Daoud1190/Reception_moteur_main/README.md

## Reception main robotisé
   

> © INRACI

https://github.com/Daoud1190/Reception_moteur_main/assets/146357859/5e3157b3-9342-42ab-822f-edbbf6c9f63c



## Table des matières
- [Source du projet](#source-du-projet)
- [Introduction](#introduction)
- [Les caractéristiques](#les-caractéristiques)
  - [Général](#général)
  - [Electronique](#electronique)
  - [Mécanique](#mécanique)
- [Liste des composants](#liste-des-composants)
  - [Electronique](#electronique-1)
  - [Mécanique](#mécanique-1)
- [Schéma bloc](#schéma-bloc)
  - [Gant](#gant)
  - [Main](#main)
- [Schéma de principe sans connecteur](#schéma-de-principe-sans-connecteur)
- [Fichier sources easyEDA](#pcb)

## Source du projet
[Gotronic Blog](https://www.gotronic.fr/blog/articles/controle-dune-main-robotique/)



## Introduction
A l'occasion de mon TFE de fin de 6ème année secondaire, j’ai décidé de mener un projet qui va me permettre d’appliquer mes connaissances acquises grâce à mon apprentissage à l’INRACI. 
Le but de mon projet est de créer une main que l’on pourra contrôler grâce à un gant à distance. 
Mes motivations pour ce projet viennent de ma passion pour la domotique et le contrôle à distance. 
Depuis tout petit, je suis fasciné par les entités contrôlées à distance et ce projet est l’occasion de rallier ce que j’aime et l’électronique. 
Rapide explication :
Les servos moteurs qui seront reliés aux doigts de la main robotique vont être branchés à une première carte ESP32 qui communiquera avec une deuxième carte ESP32. Cette dernière sera branchée aux 5 capteurs de flexion qui seront collés aux gants. Les deux cartes pourront communiquer grâce à leurs options BT intégrées.  

## Les caractéristiques
### Général
| | Main | Gants |
|---|---|---|
| 2 boutons poussoir | Sur la carte ESP32 | Sur la carte ESP32 |
| 1 LED | LED sur la carte ESP32 | LED sur la carte ESP32 |
| Main robotique avec 5 servos moteurs| Servo moteur SG90 | X |
| Gants avec 5 capteurs de flexion (x résolutions)| X | A déterminer |

### Electronique
| | Main | Gants |
|---|---|---|
| BT 2,4 GHz | Sur la carte ESP32 | Sur la carte ESP32 |
| Consommation | 170 et 250 mA pour les 5 servos moteurs | ESP32 (80-180 mA) |
| Batteries 5 volt | A déterminer | A déterminer |

### Mécanique
| | Main | Gants |
|---|---|---|
| Poids | 289g | 5g |
| Matière | Acrylique noir 5.0 | Tissu |

## Liste des composants
### Electronique
- [2X Adafruit Carte Feather HUZZAH32 ESP32](https://www.adafruit.com/product/3405)
- [5x Capteur de Force, ZD10-100 500g](https://www.gotronic.fr/art-capteur-de-force-flexiforce-100-lb-31526.htm)
- 1X Batterie
- [1X M5PAPER](https://shop.m5stack.com/products/m5paper-esp32-development-kit)
- 5X résistances smd
- 1X interrupteur
- 5X fusibles réarmable PTC

### Mécanique
- 1X Bras mécanique
- [5X servo moteur (SG90)](https://www.towerpro.com.tw/product/sg90-7/)
- 1X Gants en tissus

## Schéma bloc
### Gant


### Main


##  Schéma de principe sans connecteur


## PCB
(https://oshwlab.com/daoud01/pcb-moteur)

> [!NOTE]
> Appuyer sur l'image pour acceder au projet sur Easyeda
