Daoud1190/Reception_moteur_main/Oulad_El_Fadel_Main_Robotisée.pdf

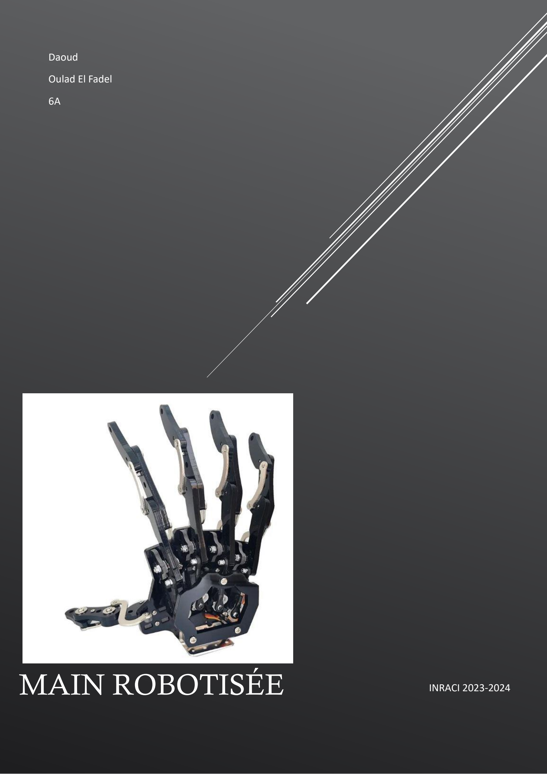
[picture p1: page 1]

Daoud

Oulad El Fadel

6A

MAIN ROBOTISÉE | INRACI 2023-2024

« Si vous voulez trouver les secrets de l'univers, pensez en termes d'énergie, de fréquence, d'information et de vibration. »

— Nikola Tesla

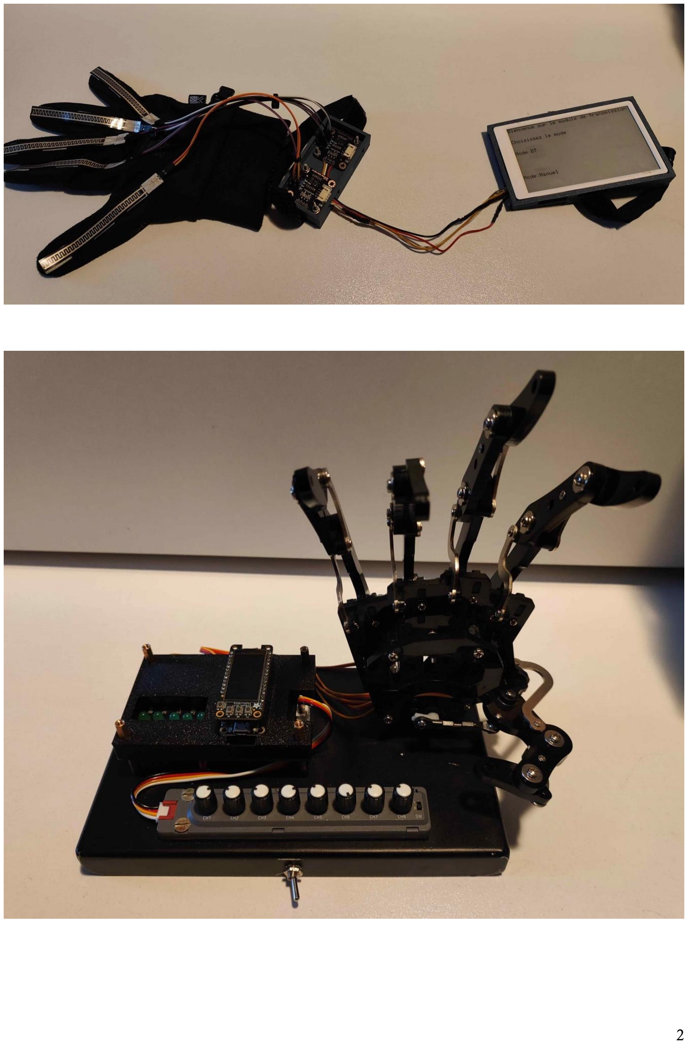
[picture p2: page 3]

Mes remerciements les plus sincères à mon promoteur monsieur Kapita pour sa formation et la mise à disposition de son temp et de son matériel pour mener à bien mon projet. Une personne inspirante qui a mon plus grand respect.

Mes remerciements à Thomas Giarrizzo qui a été un camarade exceptionnel et d’une grande aide. Je voudrais aussi remercier mes parents et Nathan et mes autres camarades pour le soutient qu’ils m’ont apporté.

Table des matières

## 1. L’introduction

À l’occasion de mon TFE de fin de 6-ème année secondaire. J’ai décidé de mener un projet qui va me permettre d’appliquer mes connaissances acquises grâce à mon apprentissage à l’INRACI.

Le but de mon projet est de crée une main que l’on pourra contrôle grâce à un gant à distance.

Mes motivations pour ce projet viennent de ma passion pour la domotique et le contrôle à distance.

Depuis tout petit je suis fascinée par les entités contrôler à distance et se projet est l’occasion de rallier ce que j’aime et l’électronique.

Rapide explication

Les servos moteurs qui seront reliés aux doigts de la main robotique vont être branchés à une première carte ESP32 qui communiquera avec la même carte. La deuxième carte sera elle branchée aux 5 capteurs de flexion qui seront collés aux gants. Les 2 cartes pourront communiquer grâce à leurs options BT intégrées.

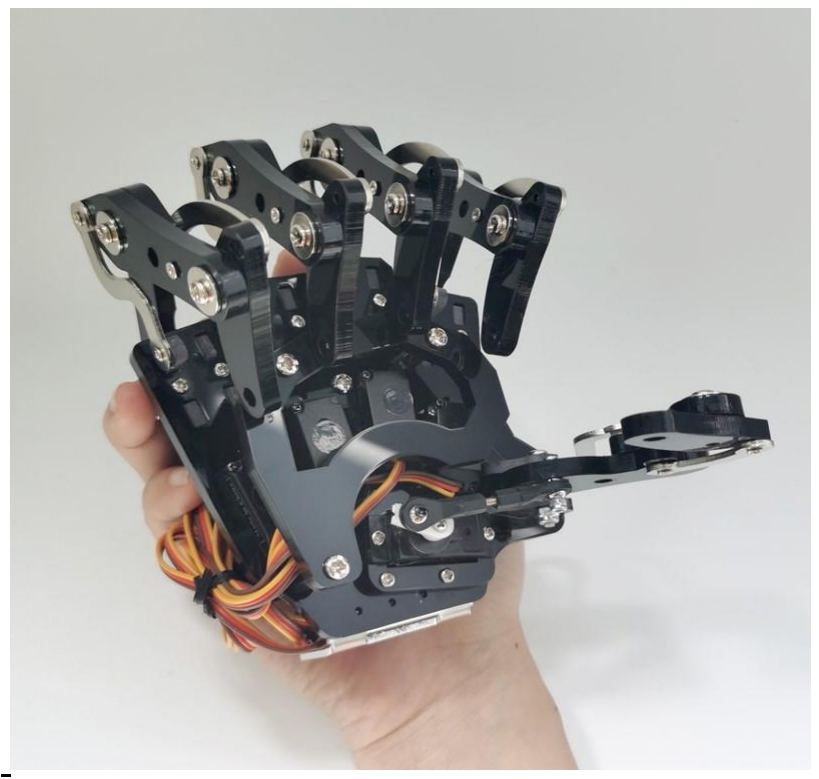
[picture p3: figure]
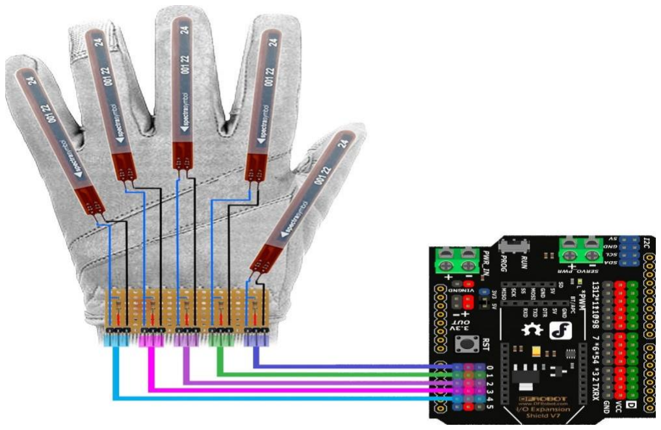
[picture p4: figure]

## 2. Les caractéristiques

Caractéristiques :

Général : | Main | Gants
-2 boutons-poussoirs | Sur la carte ESP32 | Sur la carte ESP32
-1 Led | LED sur l’Esp32 | LED sur l’Esp32
-Main robotique avec 5 servomoteurs | Servomoteur SG90 | X
-Gants avec 5 capteurs de flexions (x résolutions) | X | Capteur de flexion ZD10-100
Électronique : | Main | Gants
-BT 2,4 GHz | Sur la carte ESP32 | Sur la carte ESP32
-Consommation | 170 et 250 mA pour les 5 servomoteurs | ESP32 (80-180 mA)
-Batteries 5 volts | X | Inclus (dans la m5 Paper)
Mécanique : | Main | Gants
Poids | 289g | 5g
Matière | Acrylique noir 5.0 | Tissu

Liste des composants :

Électronique

-2X Adafruit Carte Feather HUZZAH32 ESP32

- 5x Capteur de Force, ZD10-100 500g

-2X Batteries (a determiner)

-1X M5PAPER

Mécanique

-1X Bras mécanique

-5X servomoteurs (SG90)

-1X Gants en tissus

## 3. Les principes mis en jeu

Démodulation

Description détaillée

Notre projet comporte 2 parties (le gant avec une M5 Paper et la main robotique avec une ESP32) qui vont se transmettre des informations via une connexion Bluetooth. Nos 2 dispositifs de communication sont dotés de ce type de transmission. Cette technologie de transmission de données nous permet d’échanger des données entre la M5 Paper et l’ESP32. Elle nous permet aussi d’avoir une communication sécurisée grâce au chiffrement de données et d’avoir un temps de connexion rapide.

Caractéristiques détaillées

1 Portée de communication

La portée de communication est de 10 mètres entre nos 2 systèmes.

2 Fréquence de communication

La fréquence utilisée est de 2,4 GHz.

3 Maitre multiple

Il peut avoir plusieurs esclaves contrôlés par 1 seul maitre.

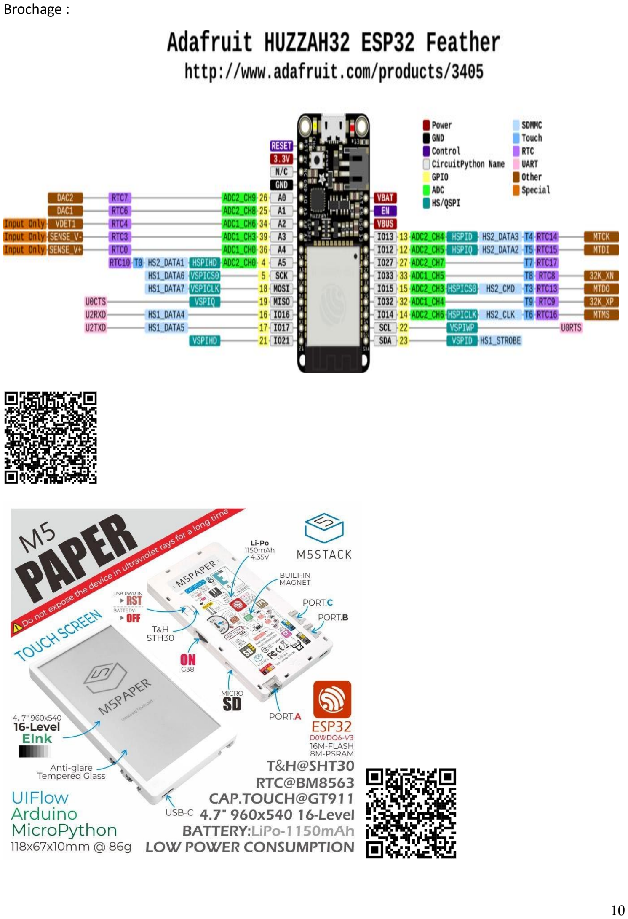
[picture p5: page 11]

Brochage :

Étude théorique du principe physique de la réception (démodulation) Bluetooth.

Le principe de modulation utilisé est le GFSK qui est une technique de variation de fréquences qui est utilisée pour transmettre des données.

L’émetteur (M5 Paper) va envoyer les données moduler en GFSK via une radiofréquence vers l’esp32.

L’ESP32 grâce à une antenne va capter l’onde et acheminer le signal vers le circuit de réception.

Avant d’arriver à l’étape de démodulation le signal va être filtré, le bruit capté va être éliminé et le signal utile va être renforcé.

Le circuit de réception va démoduler le signal reçu en traduisant les variations de fréquence pour récupère les données originales.

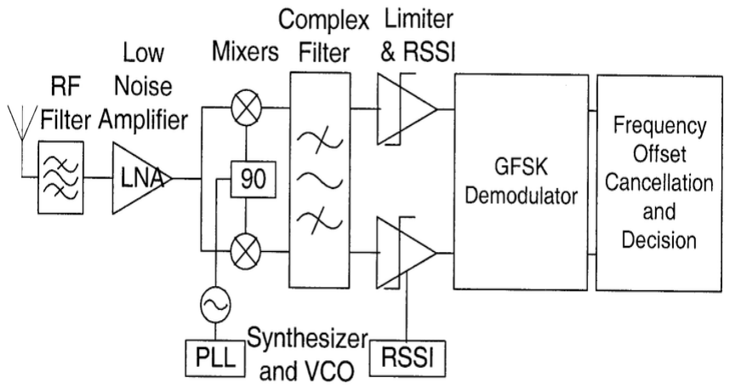
[picture p6: figure]

Programmes de test

char receiveData[7] //Tableau pour stocker les données reçues

// Initialisation de la communication série Bluetooth SerialBT.begin(device_name);
// Définition du code PIN pour le couplage Bluetooth SerialBT.setPin(pin);
Serial.println("Using PIN");

if (SerialBT.available()) {
SerialBT.write(Serial.read());
DATA = SerialBT.read(); // Lire le caractère envoyé via Bluetooth }

// Affiche les données reçues Serial.println(receiveData[0]); Serial.printf("a:%d\n", receiveData[1]); Serial.printf("b:%d\n", receiveData[2]); Serial.printf("c:%d\n", receiveData[3]); Serial.printf("d:%d\n", receiveData[4]); Serial.printf("e:%d\n", receiveData[5]); Serial.printf("f:%d\n", receiveData[6]);

Librairie utiliser

"BluetoothSerial.h" version 1.0.1.

Auteur : Henri Abrahamsen (https://www.arduinolibraries.info/authors/hen1227)

Site consulté le 31/01/2024 à 21 :43

"ESP32Servo.h" version 1.1.2
Auteur: Kevin Harrington, John K. Bennett Site consulté le 14/02/2024 à 21 :26

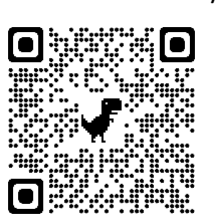
[picture p7: figure]

Voici le lien pour en savoir plus sur le code (https://github.com/Daoud1190/Reception_moteur_main)

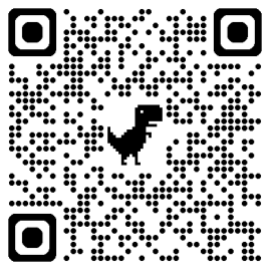
[picture p8: figure]

Encodeur

Introduction

L’un des sous-ensembles de notre projet est le 8-encoder Unit qui nous permet de contrôler les moteurs qui contrôlent les doigts de la main. Les encodeurs utilisés pour notre projet sont les EC11 qui sont des encodeurs incrémentaux. La position des encodeurs est communiquée grâce à microcontrôleur en I2C vers notre ESP32.

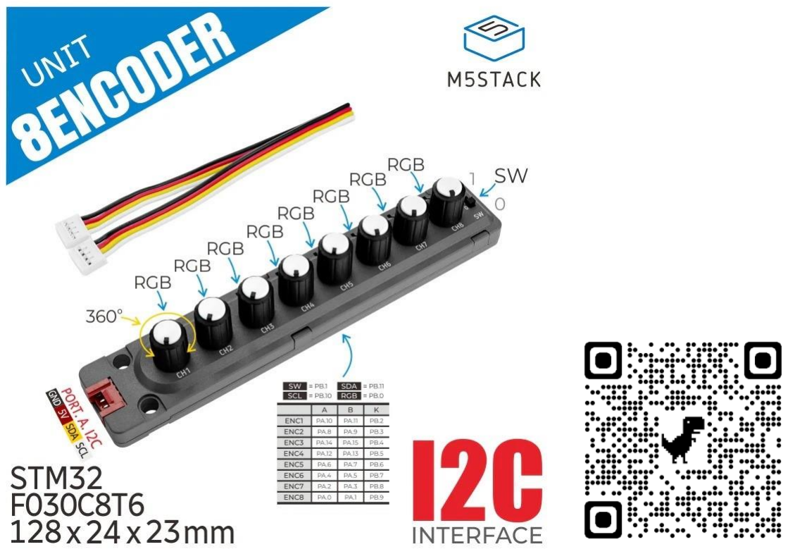
[picture p9: figure]

Fonctionnement d’un encodeur incrémental

Définition :

Un encodeur incrémental est un capteur qui suit le mouvement d’un objet en incrémentant ou décrémentant sa position par rapport à une position de référence.

L’encodeur incrémental est constitué de 2 parties : le stator et le rotor.

Le rotor est la partie tournante qui est relié l’entité dont on souhaite mesurer la position, la distance ou la vitesse.

Le stator est la partie fixe sur laquelle se trouve le capteur qui va nous permettre de mesurer les données que l’on veut (vitesse, position, etc.).

Fonctionnement :

Pin « DT » : Son rôle est de fournir un signal de données qui changent selon la position des contacts.

Pin « CLK » : Son rôle est de fournir un signal d’horloge qui change selon la position des contacts.

Pin « commune » : Elle est branchée au GND.

L’encodeur est composé d’un disque qui comporte des zones blanches conductrices et des zones noires non conductrices. Lorsque l’on va tourner le disque, l’un des 2 groupes de pin va passer sur une zone conductrice ce qui va créer un court-circuit.

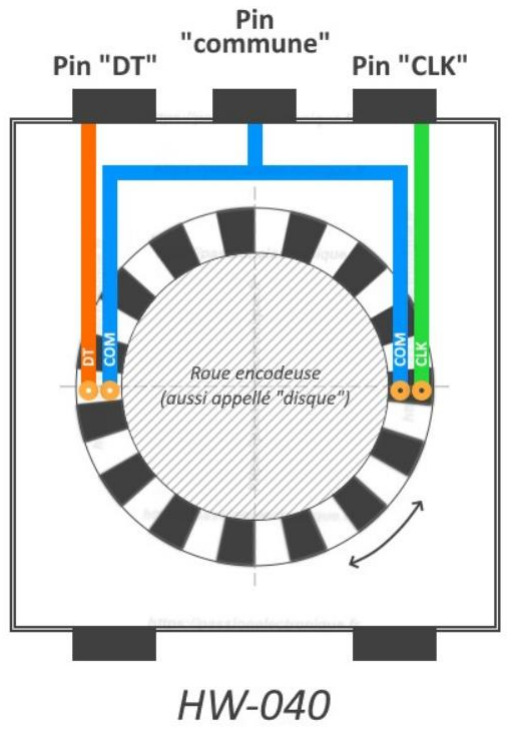
[picture p10: figure]

Traitements des impulsions électriques

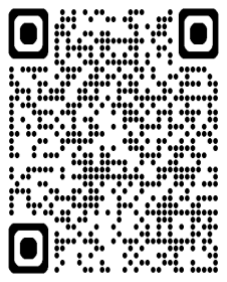
[picture p11: figure]

Pour obtenir l’information souhaitée, il faut traiter les impulsions électriques générées par le capteur. Le système chargé d’effectuer le traitement des impulsions est un compteur qui va compter les impulsions et incrémenter ou décrémenter selon le déplacement de l’objet.

Le codeur va délivre 2 signaux carrés (A et B) grâce à des contacts mécanique qui vont alterner entre l’état ON ou OFF ce qui va créer un déphasage qui va nous permettre de déterminer la position de l’objet et le sens de rotation. Chaque configuration des interrupteurs correspond à une position.

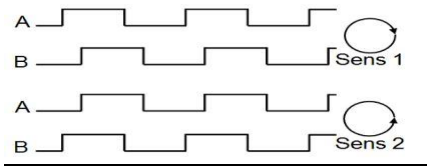
[picture p12: figure]

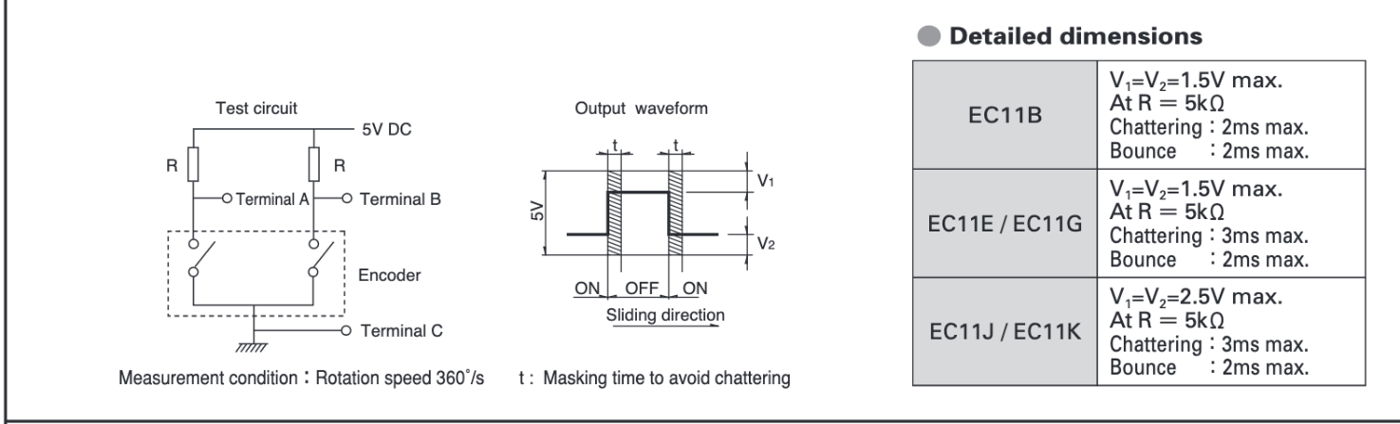
[picture p13: figure]

Les signaux A et B se comporte comme des interrupteur ouvert (ON) ou fermer (OFF) ce qui crée 2 choses :

Chattering : Variation indésirable dans les signaux.

Bounce : Rebondissement des « interrupteurs » mécanique après une ouverture ou une fermeture ce qui cause des variations indésirables dans le signal.

C’est 2 phénomènes nous montre qu’il y a une fréquence limite à ne pas dépasser pour avoir un signal lisible.

Programme de test :

void index() {
encoderValue1 = MM.getAbsCounter(1); // Lecture de la position de l’encodeur mappedValue1 = map(encoderValue1, 0, 100, 50, 100);

// Vérification des limites de l’encodeur
if (encoderValue1 <= 0) {
encoderValue1 = 0;
MM.setAbsCounter(1, 0); // Réinitialisez l’encodeur à 0

} else if (encoderValue1 >= 220) {
encoderValue1 = 220; // Forcer encoderValue à 350 si c’est le cas MM.setAbsCounter(1, 220); // Réinitialisez l’encodeur à 0
}
}
LIBRAIRIE : M5ROTATE8 (https://github.com/RobTillaart/M5ROTATE8)
Version : 0.3.0

Voici le lien pour en savoir plus sur le code (https://github.com/Daoud1190/Reception_moteur_main)

## 4.Le schéma bloc

Gant

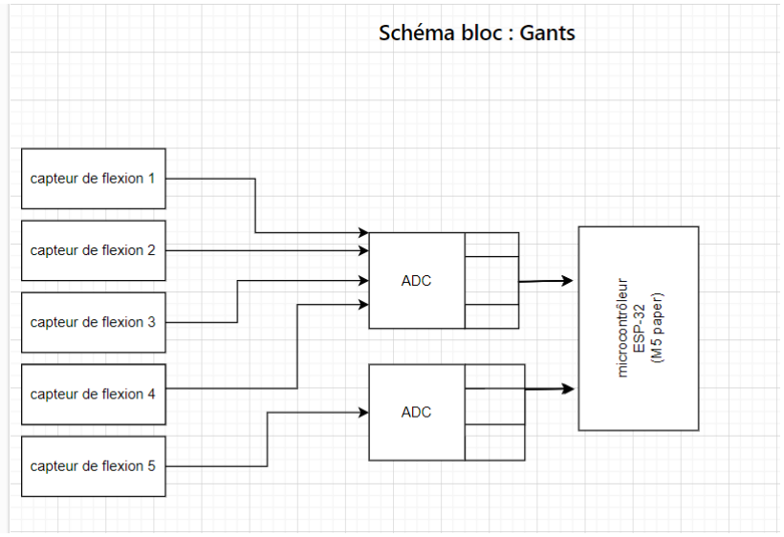
[picture p14: figure]

Gants :

Capteur de flexion et module ADC :

Les capteurs de flexion vont transmettre le mouvement à la ESP32 (M5 Paper) grâce à deux modules I2c. 2 capteurs de flexion dans l’un des modules et 3 dans l’autre. Les modules vont permettre de relier les capteurs de flexions au microprocesseur en réduisant le nombre de connexions.

M5 Paper :

L’ESP32(M5 Paper) va envoyer les instructions à l’ESP32 de la main robotisée grâce au module BT intégré. L’écran tactile intègre va afficher la position des doigts et le menu pour pouvoir choisir les différents modes de fonctionnement.

Main

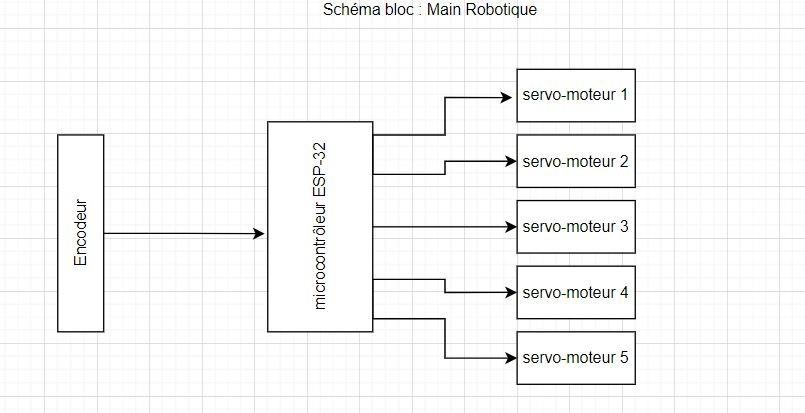
[picture p15: figure]

Main robotisée :

ESP32 et servomoteur :

Le microprocesseur de la main robotique va recevoir les instructions grâce au module BT intégré qui va ensuite les appliquer sur les ou le servomoteur concerner. L’ESP-32 va renvoyer la postions des doigts vers la M5 Paper a fin de l’afficher.

Encodeur :

Il est composé de 8 encodeurs mécaniques qui vont nous permettre de faire bouger “manuellement” nos doigts. L’encodeur est branché à l’ESP-32 qui va contrôler les moteurs selon la position des encodeurs attitrés à chaque doigt.

## 5.L’étude détaillée et les mesures

Analyse de l’écran (M5 PAPER)

Introduction
Notre projet se constitue de la M5 Paper qui va nous permettre de communiquer la position des capteurs à notre main robotique. La M5 Paper est aussi composer d’un écran le EPD_ED047TC1 qui va nous permettre d’afficher les diffèrent modes (contrôle avec le gant, mouvement avec l’écran et le mode musique) et de les sélectionner grâce au tactile de l’écran. Il va aussi nous permettre de contrôler la main robotique en appuyant directement sur le choix de la position des doigts.

Comment marche l’affichage ?
L’écran utilise la technologie E-Ink qui permet un affichage à très faible consommation et n’a pas besoin d’énergie pour laisser une image afficher, car il ne consomme que lorsque l’image est modifiée. L’écran est composé de pixels dans lesquelles il y a de l’encre composée de billes de pigments chargé positivement pour créer un pigment blanc et négativement pour créer un pigment noir qui baignent dans un fluide transparent. Lorsque l’on va vouloir afficher la couleur noire, nous allons envoyer une tension électrique négative pour attirer les billes de pigments blancs et repousser de l’autre cotée du fluide, une tension positive pour attirer les billes de pigments noirs et repousser les charges négatives de l’autre cotée du fluide. Sans présence de tension, les pigments restent à leur place.

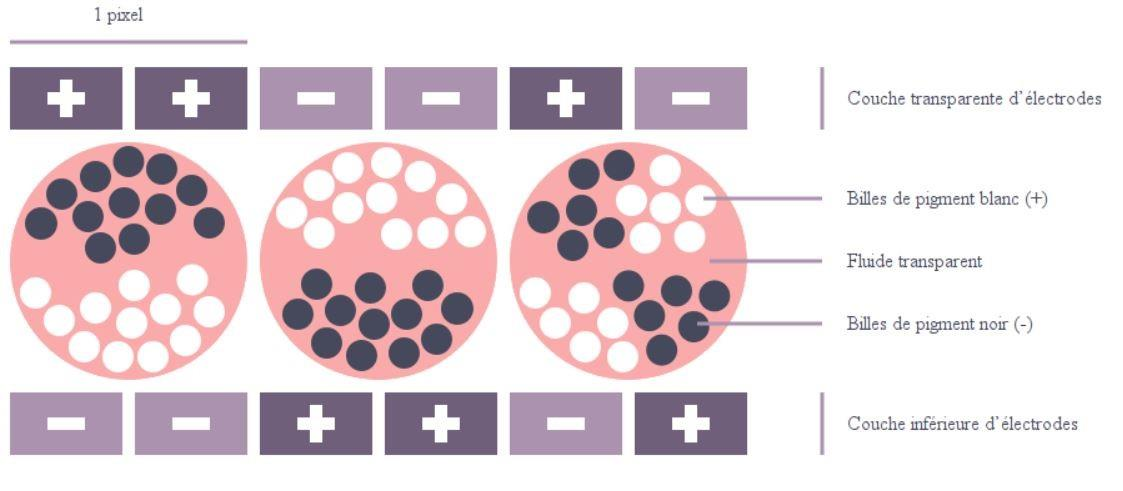
[picture p16: figure]

Comment fonctionne le tactile ?
L’écran va être traversé par un champ électrique faible qui quadrille l’écran. Le doigt est un conducteur électrique et lorsque l’on va appuyer sur une partie de l’écran le champ électrique va être perturbé et le processeur va pouvoir sur quelle partie du quadrillage le champ a été perturber.

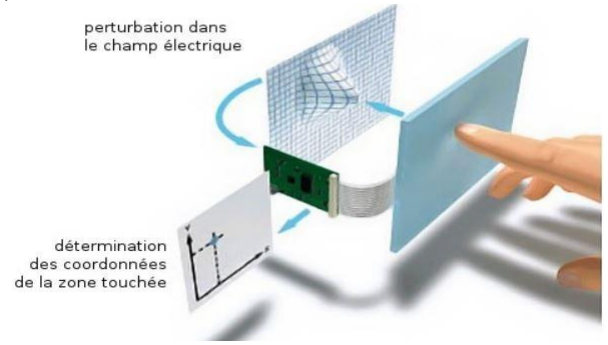
[picture p17: figure]

Code de “teste”:

if (M5.TP.available()) {
if (!M5.TP.isFingerUp()) { M5.TP.update();
canvas.fillCanvas(0);
bool is_update = false;
for (int i = 0; i < 2; i++) {
tp_finger_t FingerItem = M5.TP.readFinger(i); if ((point[i][0] != FingerItem.x) || (point[i][1] != FingerItem.y)) { is_update = true;
point[i][0] = FingerItem.x;
point[i][1] = FingerItem.y;
canvas.fillRect(FingerItem.x - 50,FingerItem.y - 50,00,100,15);
Serial.printf("Finger ID:%d-->X: %d*C | Y: %d | Size: %d\r\n",
FingerItem.id, FingerItem.x, FingerItem.y, FingerItem.size);
}
}
if (is_update) {
canvas.pushCanvas(0, 0, UPDATE_MODE_DU4); }
}
}
}

Voici le lien pour en savoir plus sur le code (https://github.com/Thomas2809/transmission)

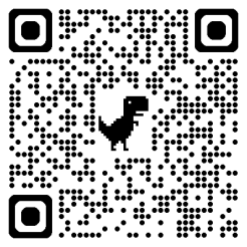
[picture p18: figure]

Caractéristiques de l’écran :
Taille diagonale : 4,7" (https://www.panelook.com/sizmodlist.php?sizes%5b%5d=470)
Zone active : 58,32 (L) × 103,68 (H) mm
Type d’interface : Données parallèles (1 canal, 8 bits), connecteur 44 broches Résolution : 540 × 960, qHD 235 PPI
Fréquence : 85Hz
Tension d’entrée : 3,3 V (typique)
Environnement : Température de fonctionnement : 0 ~ 50 °C ; Température de stockage. : -25 ~ 70 °C
Niveau de gris : 16

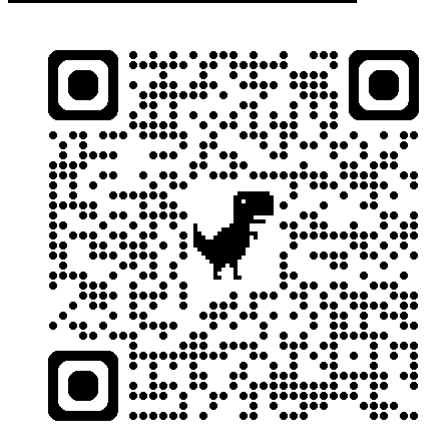
[picture p19: figure]

Datasheet de l’écran

Module ADS1115

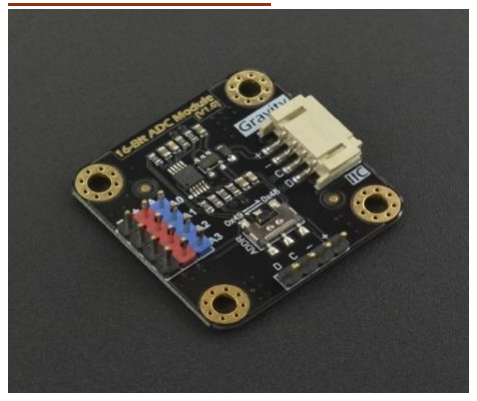
[picture p20: figure]

Introduction

Pour transmettre à notre MCU le signal analogique qui correspond à la position du doigt acquise grâce à nos capteurs de flexion nous avons besoin de d’abord convertir le signal analogique en signal numérique. Ce rôle sera rempli grâce à nos 2 modules ADC.

Qu’est-ce qu’un ADC

C’est un périphérique qui convertit un signal analogique en signal numérique.

Schéma interne du module ADS1115

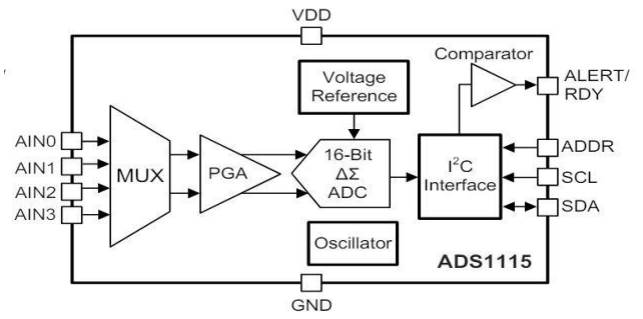
[picture p21: figure]

AIN correspond à l’entrée analogique de notre convertisseur.

Le MUX corresponds à un multiplexeur qui va sectionner l’entrée que nous voulons lire.

Le signal va ensuite passer par le PGA (Programmable Gain Amplifier) qui va amplifier le signal avec un Gain que l’on peut programmer.

Ensuite le signal est traité par le convertisseur delta-sigma de 16-bits pour récupérer un mot binaire. 16 bits représentent les différentes tensions disponibles (65536).

L’interface I²c permet de communiquer nos valeurs numériques au microcontrôleur qui les traiter.

Le comparateur va comparer la tension d’entrer du bloc interface I²c a une tension de référence et va créer une alerte quand la tension de référence est dépassée.

L’oscillateur permet de synchroniser les différents blocs entre eux grâce un signal d’horloge.

Capteur de flexion

Introduction

Pour notre projet nous avons besoin de connaitre la position des doigts de l’utilisateur et pour cela nous allons utiliser des capteurs de flexions.

Qu’est-ce qu’un capteur de flexion

Le capteur de flexion est une bande dont la résistance va varier selon la flexion que l’on exercer avec.

Le capteur est constitué d’encre polymère composée de particules conductrices qui vont s’écarter lorsque l’on plie le capteur ce qui va augmenter la résistance. Selon le degré de flexion, la résistance va varier.

Le capteur doit être utilisé avec une résistance (8k2Ω dans notre cas) pour créer un pont diviseur de tension qui va lui permettre d’être lu par un convertisseur analogique /numérique.

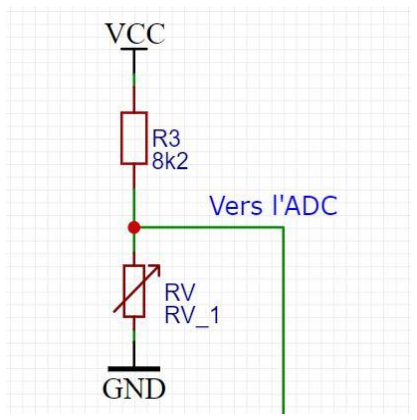
[picture p22: figure]
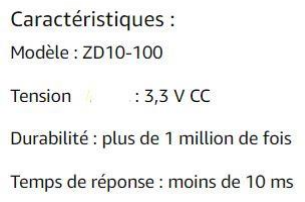
[picture p23: figure]

Le capteur de flexion a besoin d’un pont diviseur de tension pour pouvoir être lu par l’ADC.

Formule :

Rv
Rv+R3

. VCC = U adc

I²C

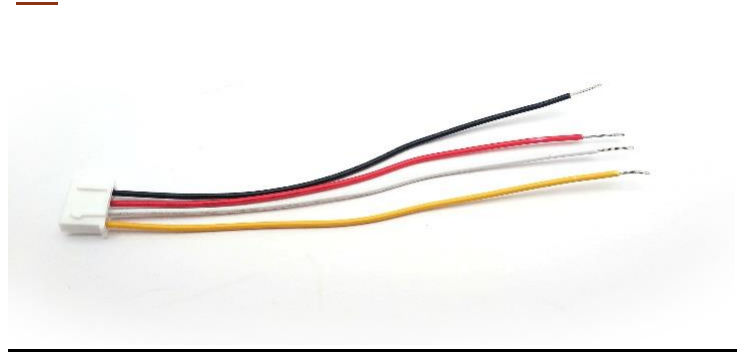
[picture p24: figure]

Introduction

Dans notre projet nous avons besoin de faire communiquer nos modules entre eux et pour cela nous avons besoin d’un bus de communication qui dans notre cas est le bus I²C.

qu’est-ce qu’un bus I²C

L’I²C est un bus de communication développé par PHILIPS dans les années 80 et qui avait pour but de relier plusieurs périphériques à un seul microprocesseur.

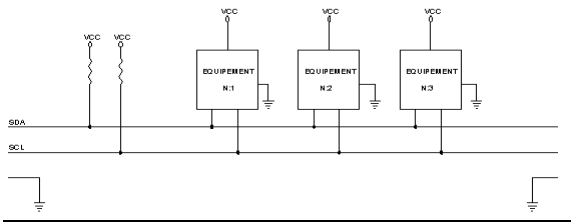
[picture p25: figure]

L’I2C est composée de 3 fils : SDA, SCL, Masse.

Il est half duplex donc on peut lire et écrire, mais pas en même temps.

Le SDA représente le signal de la data qui correspond à nos données.

Le SCL représente le signal d’horloge qui synchronise les appareils entre eux.

Pour communiquer, les périphériques doivent avoir une adresse. Dans ce cas nous avons la transmission d’une adresse.

Les bits d’A6 à A0 contiennent l’adresse. L’adresse est unique pour chaque appareil.

Le bit R / W indique si le maitre s’apprête à lire ou écrire.

Un bit ACK (Acknowledge) doit être envoyé par le périphérique qui a reçu l’adresse pour confirmer au maitre qu’il l’a bien reçu.

Écriture

SCL correspond au signal d’horloge.

SDAM correspond au signal envoyer par le maitre.

SDAE correspond au signal envoyer par l’esclave.

SDAR correspond aux 2 signaux.

Ici nous pouvons voir l’adresse de A6 à A0 avec le R/W et ACK ensuite nous avons les donner de D7 à D0 et un ACK à la fin que l’esclave doit envoyer pour confirmer la réception.

Lecture d’une donnée par le maitre

Après avoir lu la donnée, le maitre va mettre ACK à 0 si il veut lire les autres données.

Mesures sur les servomoteurs

| T (ms) | F (Hz) | Ton (ms) | Rapport cyclique r ((Ton /T). 100) )
0° | 20ms | 50Hz | 528us | 2,64
90° | 20ms | 50Hz | 1,46ms | 7,3
180° | 20ms | 50Hz | 2,36ms | 11,8

On peut remarquer que plus l’angle est grand plus le rapport cyclique augmente.

Moteur à 0°

Période

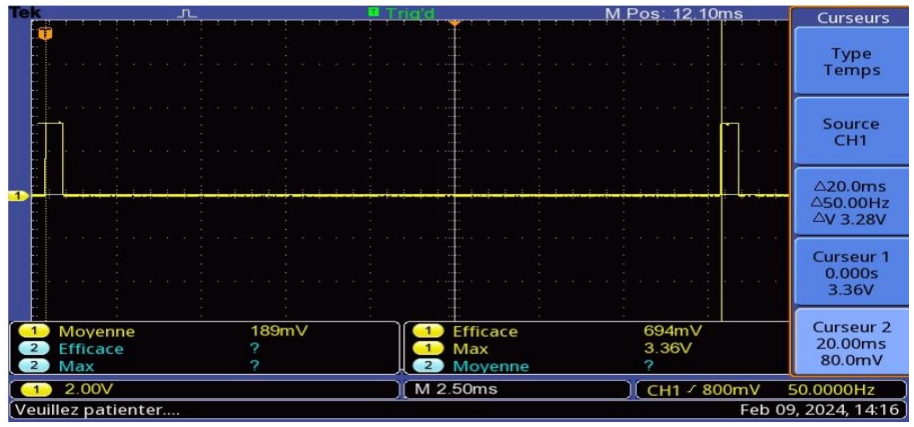
[picture p26: figure]
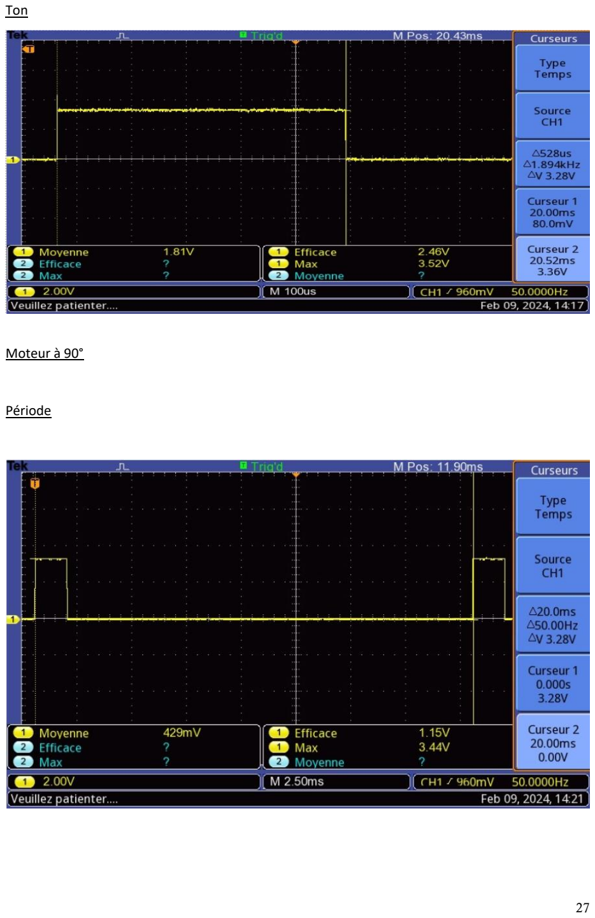
[picture p27: page 28]

Ton

Moteur à 90°

Période

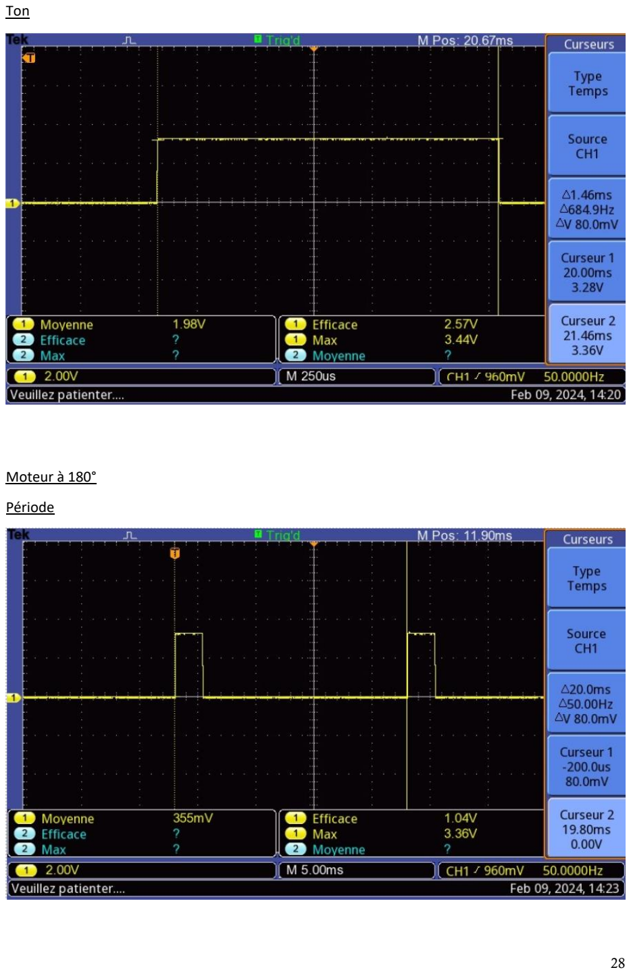
[picture p28: page 29]

Ton

Moteur à 180°

Période

Ton

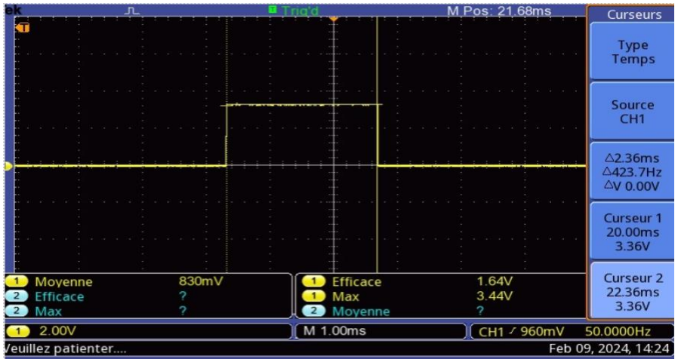
[picture p29: figure]

Mesure sur les capteurs de flexion
| Mesure (volt mètre) | Mesure (Ohm mètre) | Calcul du programme (ADC25ADC25) | Valeur en binaire
Sans flexion | 2,267V | 18k Ω | 245 | 6143 0b 0001 0111 1111 1111
Flexion a 90° | 2, 3V | 7k3Ω | 131 | 4262 0b 0001 0000 1010 0110
Flexion totale | 722mV | 2k3Ω | 83 | 489 0b 0001 1110 1001

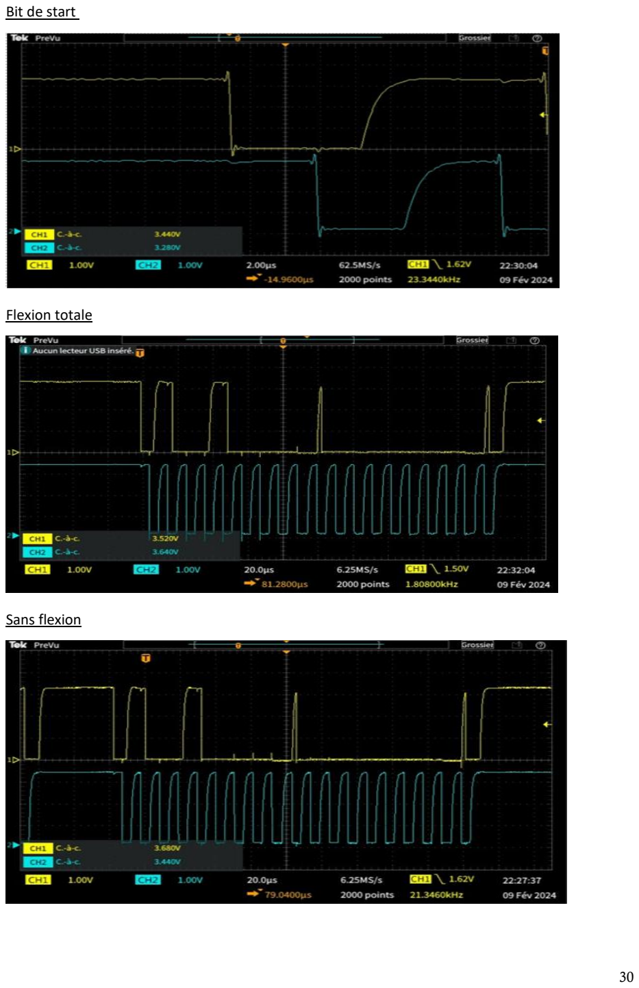
[picture p30: page 31]

Bit de start

Flexion totale

Sans flexion

Mesure de l’interruption

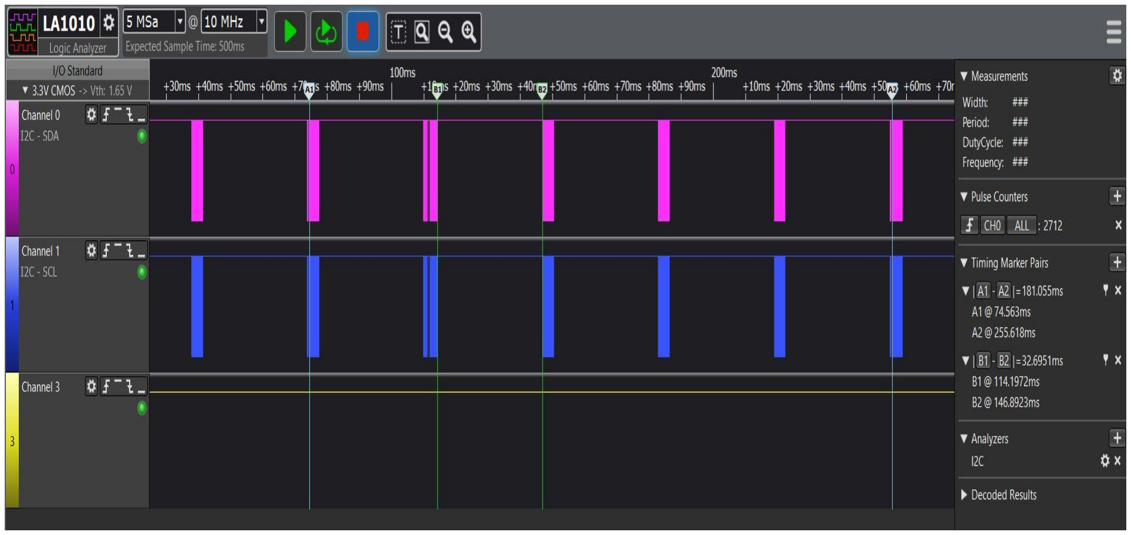
[picture p31: figure]

L’espace entre les curseurs A1 et A2 représentent la durée d’une interruption (180ms)

L’espace entre les curseurs B1 et B2 représentent la durée entre le traitement de chaque doigt (on peut voir les traitements qui correspondent à chaque doigt)

## 6.La programmation

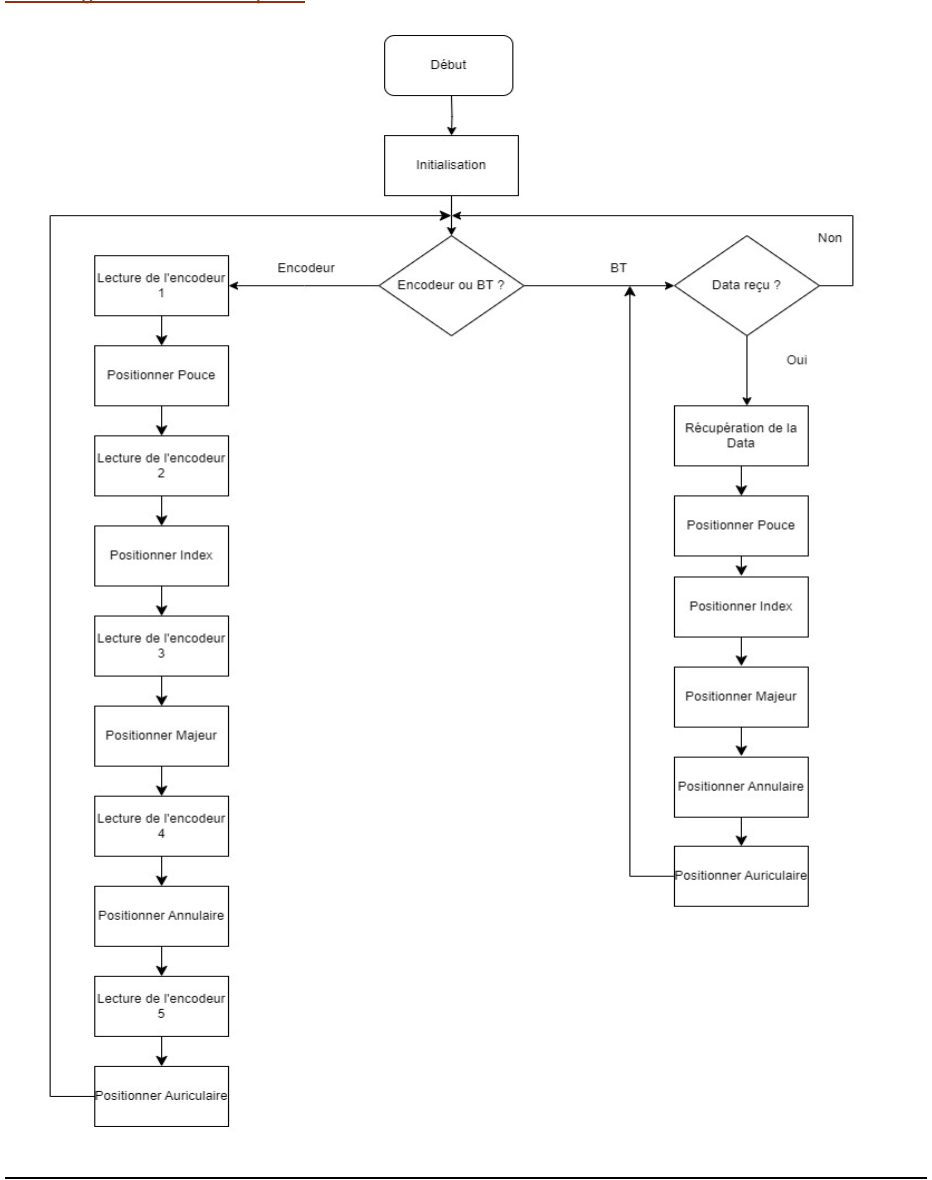
[picture p32: figure]

L’ordinogramme de la réception

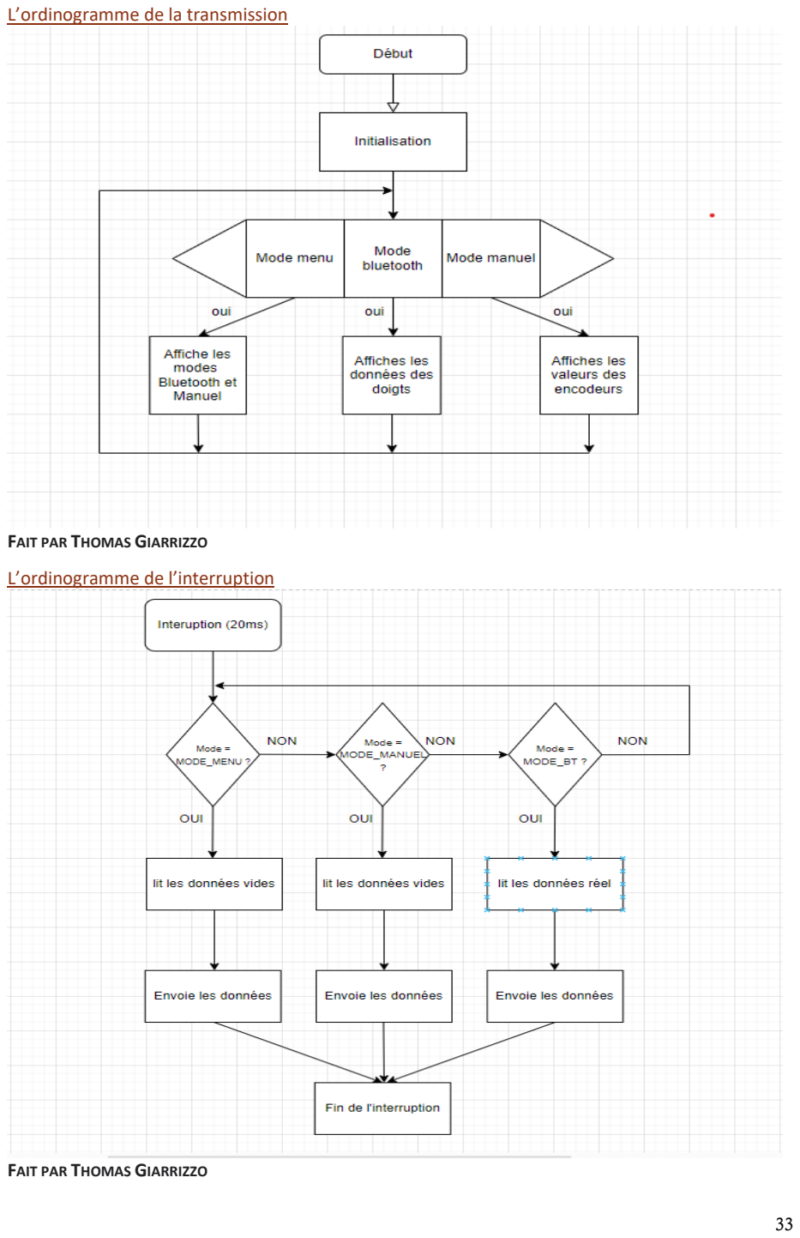
[picture p33: page 34]

L’ordinogramme de la transmission

FAIT PAR THOMAS GIARRIZZO

L’ordinogramme de l’interruption

FAIT PAR THOMAS GIARRIZZO

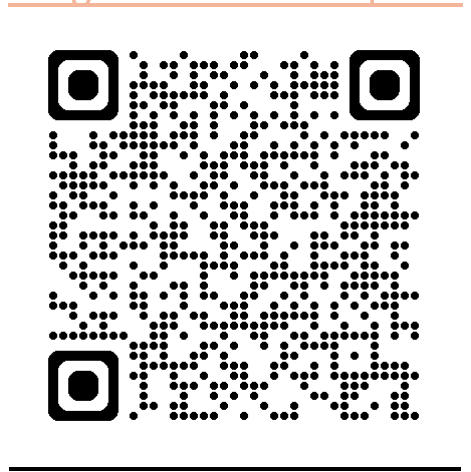
[picture p34: figure]

Programme de réception (https://github.com/Daoud1190/Reception_moteur_main)

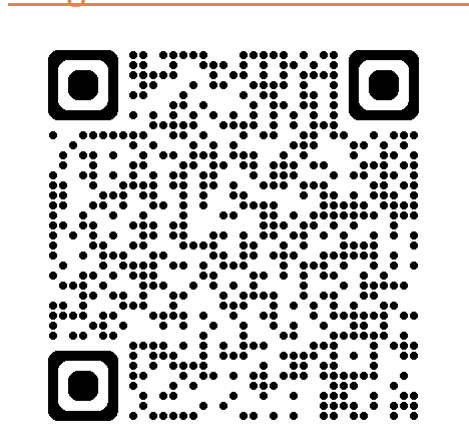
[picture p35: figure]

Programme de transmission (https://github.com/Thomas2809/transmission)

## 7. La fabrication

- Premièrement, j’ai commandé ma main et conçu mon PCB en attendant de recevoir la main.
- Après avoir tout reçu, j’ai conçu le plan du support, plier, découper et fais des trous sur de la taule. Ensuite mon père a soudé les coins.
- Pour la partie du gant, j’ai d’abord soudé les ADC pour faire les tests et les mesures et ensuite créer les plans des supports pour la M5, des modules et le capot de mon PCB. Après avoir effectué mes mesures sur les ADC j’ai branché tous mes capteurs de flexion et les ai collés avec du scotch double face aux gants.
- Enfin j’ai mis des entretoises pour fixer le PCB et placer l’interrupteur.
- Pendant tout le procédé de la conception mécanique, je codais en même temps le programme de réception.

## 8. La mise au point

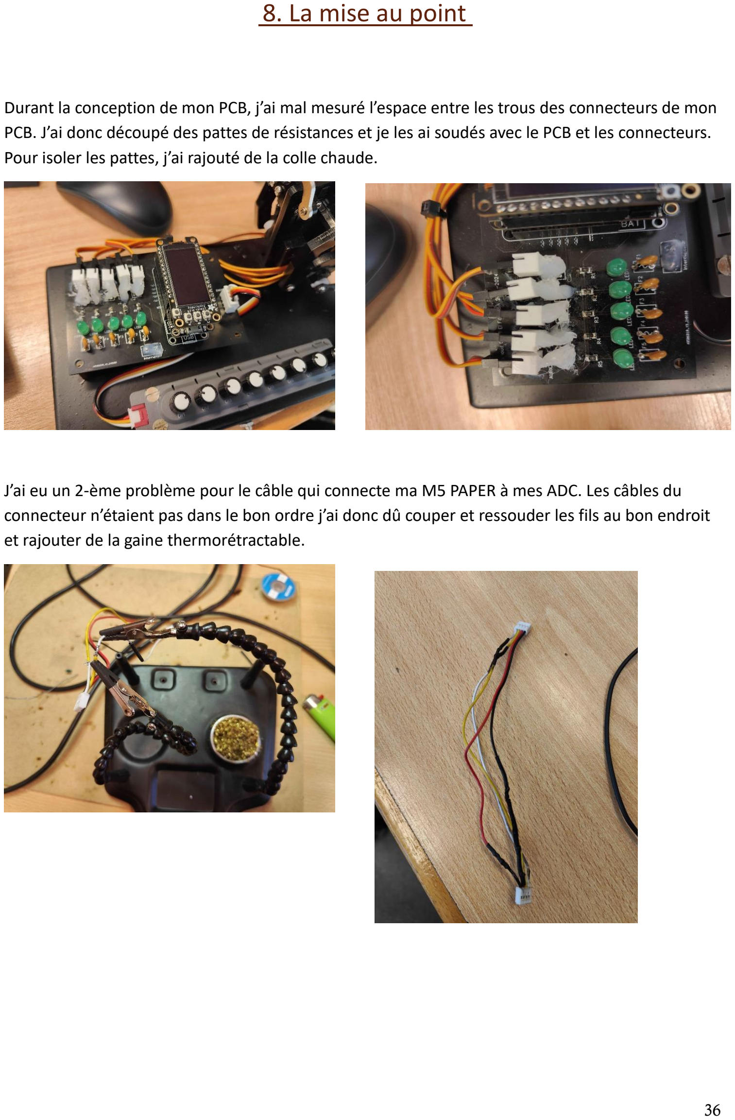
[picture p36: page 37]

Durant la conception de mon PCB, j’ai mal mesuré l’espace entre les trous des connecteurs de mon PCB. J’ai donc découpé des pattes de résistances et je les ai soudés avec le PCB et les connecteurs. Pour isoler les pattes, j’ai rajouté de la colle chaude.

J’ai eu un 2-ème problème pour le câble qui connecte ma M5 PAPER à mes ADC. Les câbles du connecteur n’étaient pas dans le bon ordre j’ai donc dû couper et ressouder les fils au bon endroit et rajouter de la gaine thermorétractable.

## 9. La conclusion

En conclusion, je suis content du résultat de mon projet même si j’aurais aimé rajouter quelque fonctionnalité en plus (ajouter une caméra qui détecte la position des doigts, contrôler les doigts grâce au tactile).

J’ai aimé faire ce projet et le partager avec les gens de mon entourage.

Cette expérience a été enrichissante pour moi, j’ai beaucoup appris et j’ai aimé partager mes travaux et aider les autres.

De plus, le fait de travailler en équipe pour mon projet m’a beaucoup aidé. J’ai pu appliquer mes compétences en électronique et les étendre pendant la conception de mon projet.

## 10. Les annexes

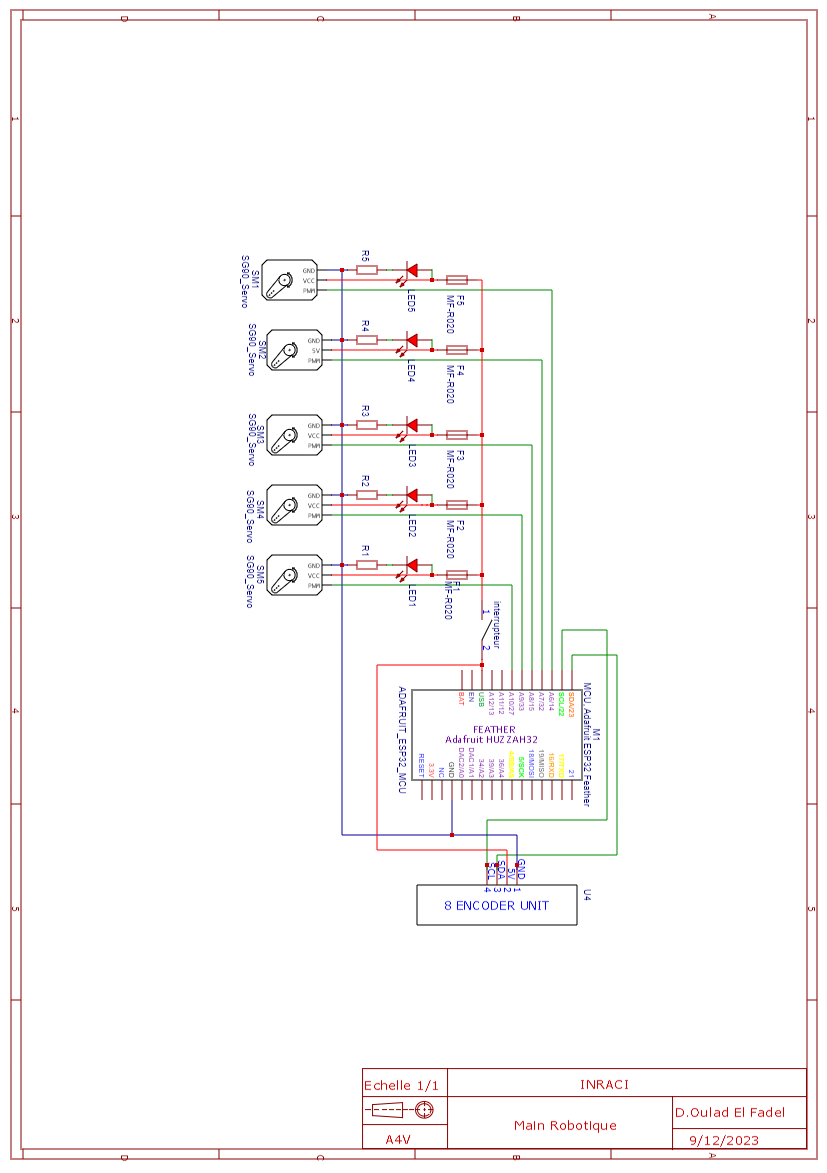
[picture p37: figure]

Schéma de principe sans connecteur

Dessin de PCB avec les pistes

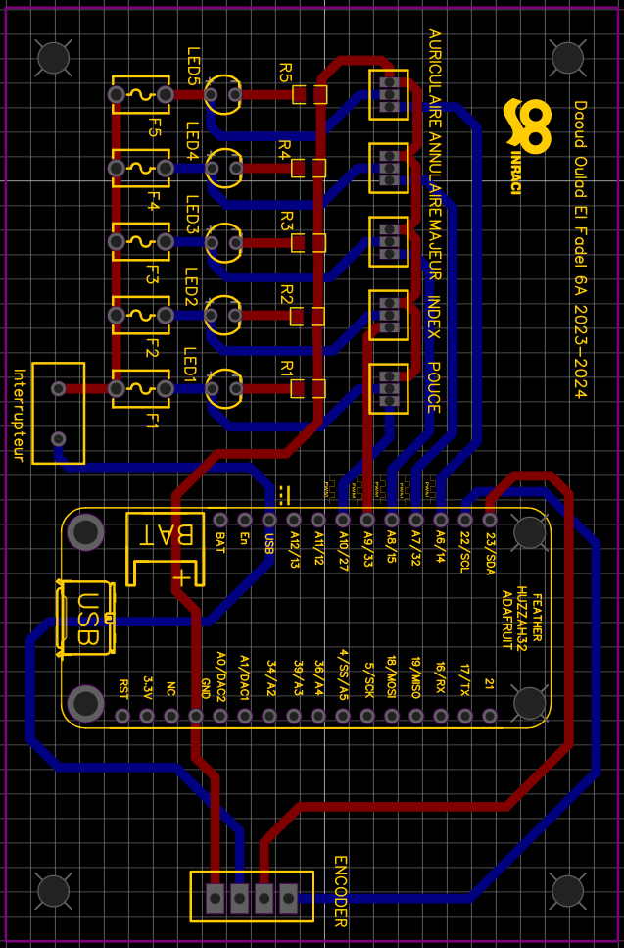
[picture p38: figure]

Dessin de PCB sans les pistes

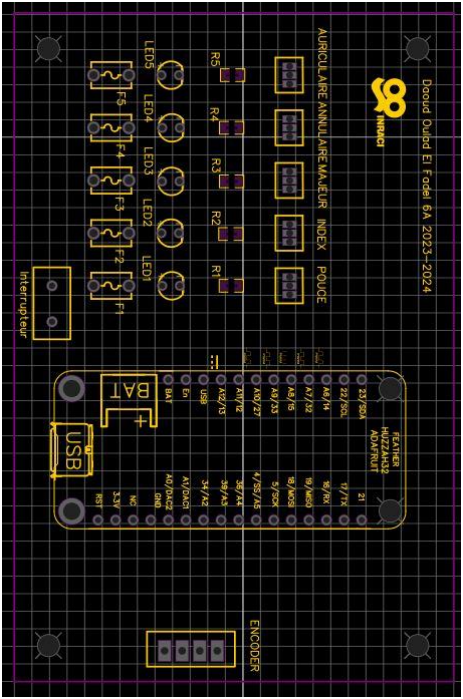
[picture p39: figure]

## 11. Vue 3D

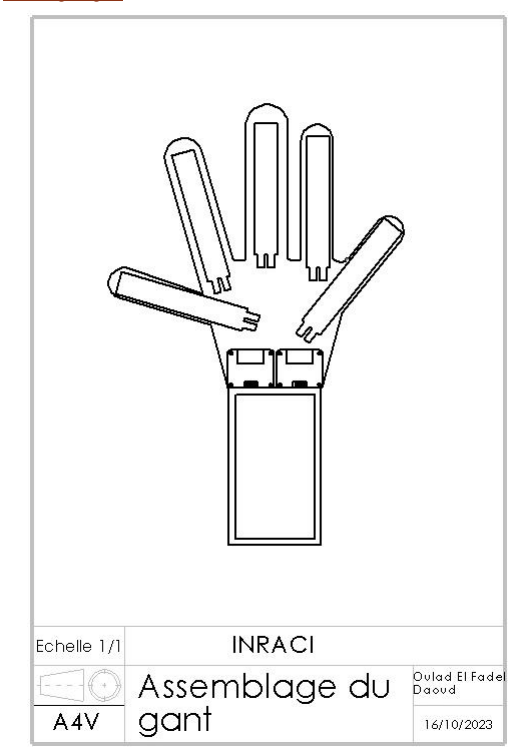
[picture p40: figure]

Assemblage du gant

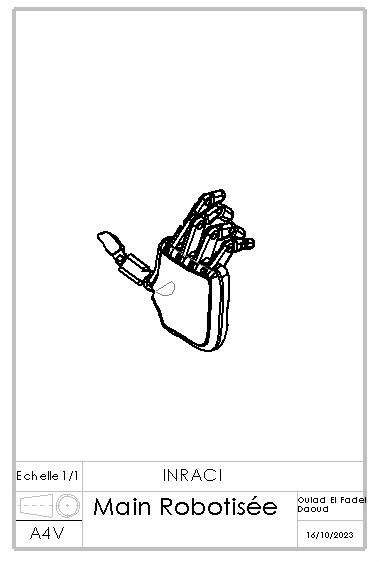
[picture p41: figure]

Main robotisée

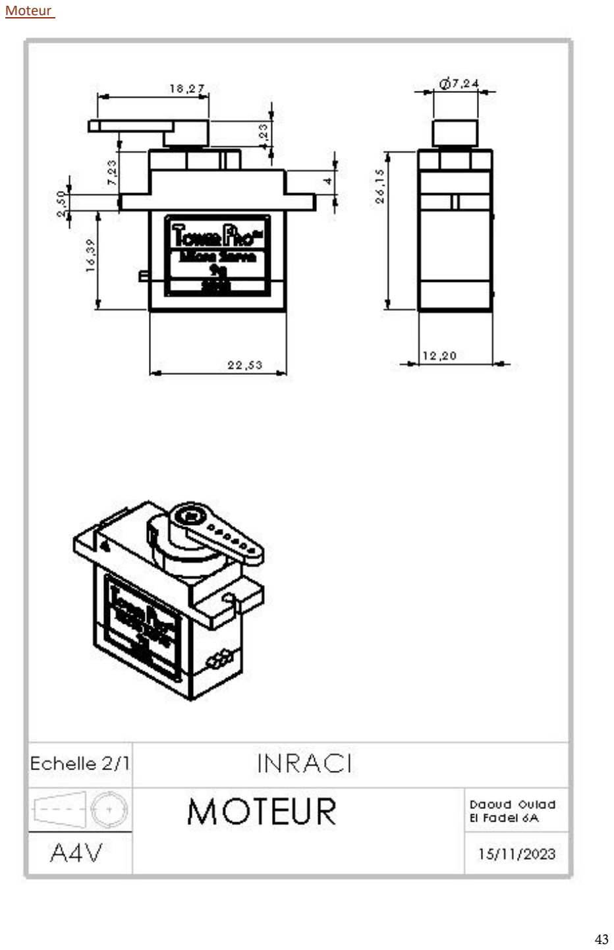
[picture p42: page 44]

Moteur

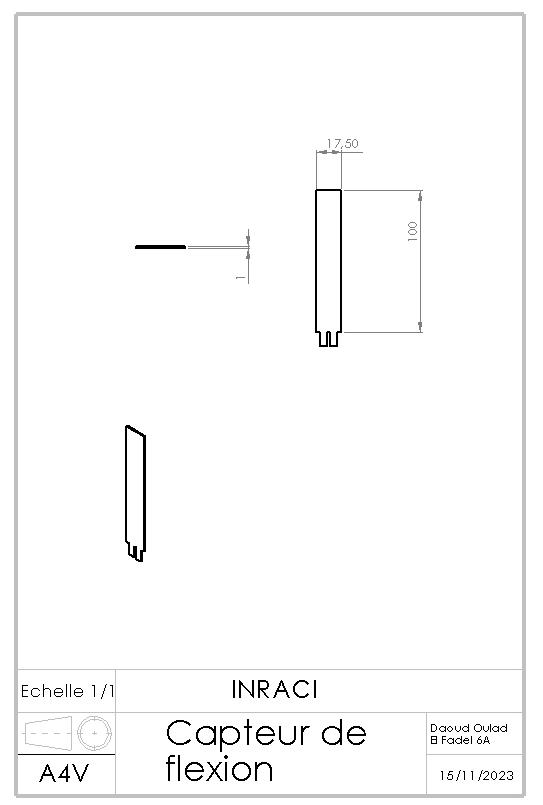
[picture p43: page 45]

Capteur de flexion

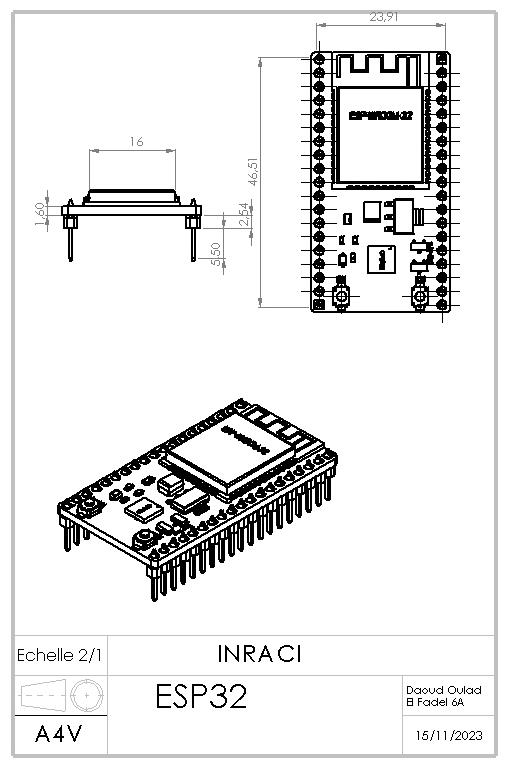
[picture p44: page 46]

ESP32

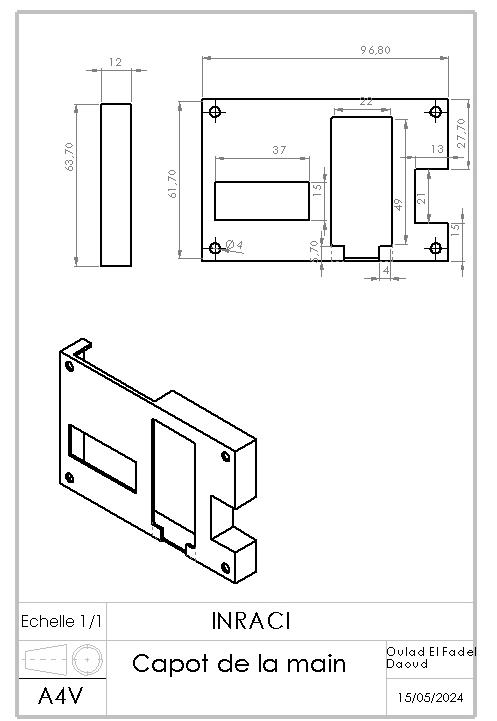
[picture p45: page 47]

Capot de la main

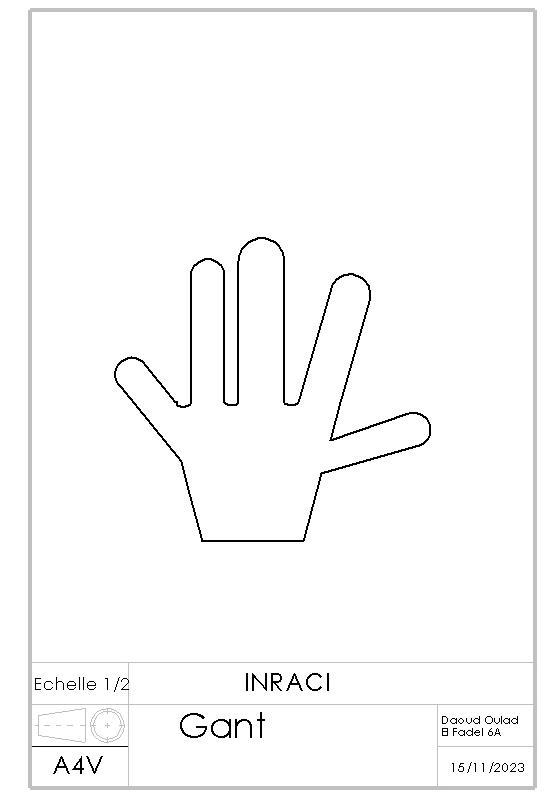
[picture p46: page 48]

Gant

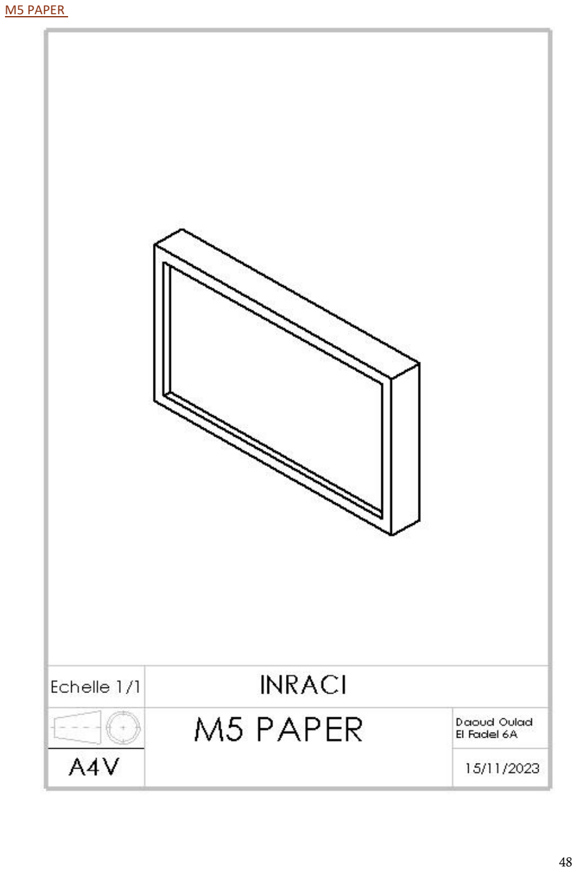
[picture p47: page 49]

M5 PAPER

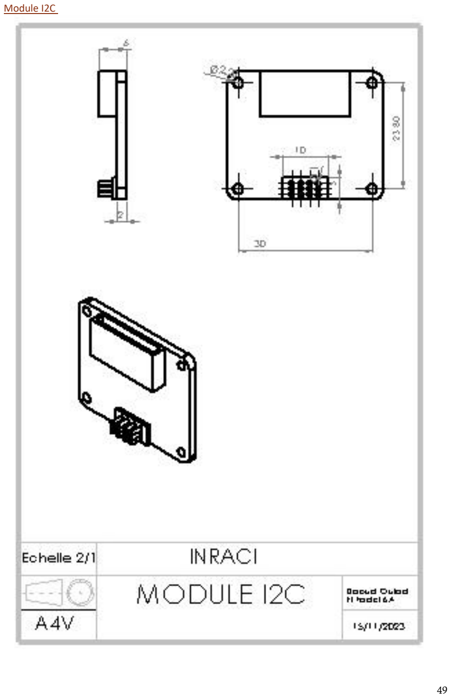
[picture p48: page 50]

Module I2C

## 12. Fiche technique des composants

ESP32

Image

Microcontrôleur | Tensilica LX6 double cœur 32 bits, 240 MHz
Fabricant de microcontrôleurs | Expressif
Système sur puce | ESP32 (https://www.espressif.com/sites/default/files/documentation/esp32_datasheet_en.pdf)
Tension d’entrée (limite) | Utilisez soit USB (5 V) soit LiPoly (3,7/4,2 V)
Tension de fonctionnement | 3,3 V
Mémoire flash | 4 Mo
SRAM | 520 Ko
Broches GPIO | 21
Broches PWM | Tous
Entrées analogiques | 14
Wifi | Émetteur-récepteur Wi-Fi 802.11b/g/n HT40
Bluetooth | Mode double (classique et BLE)

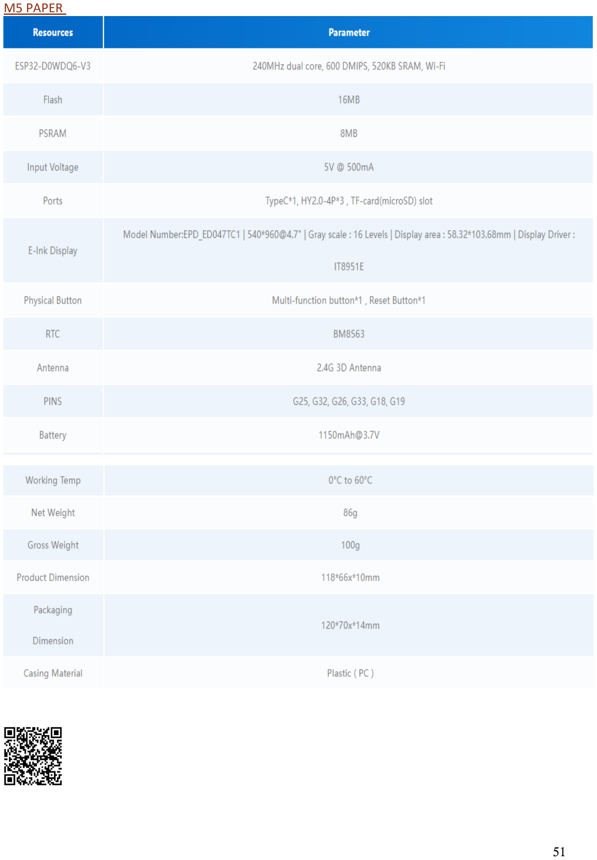
[picture p49: page 52]

M5 PAPER

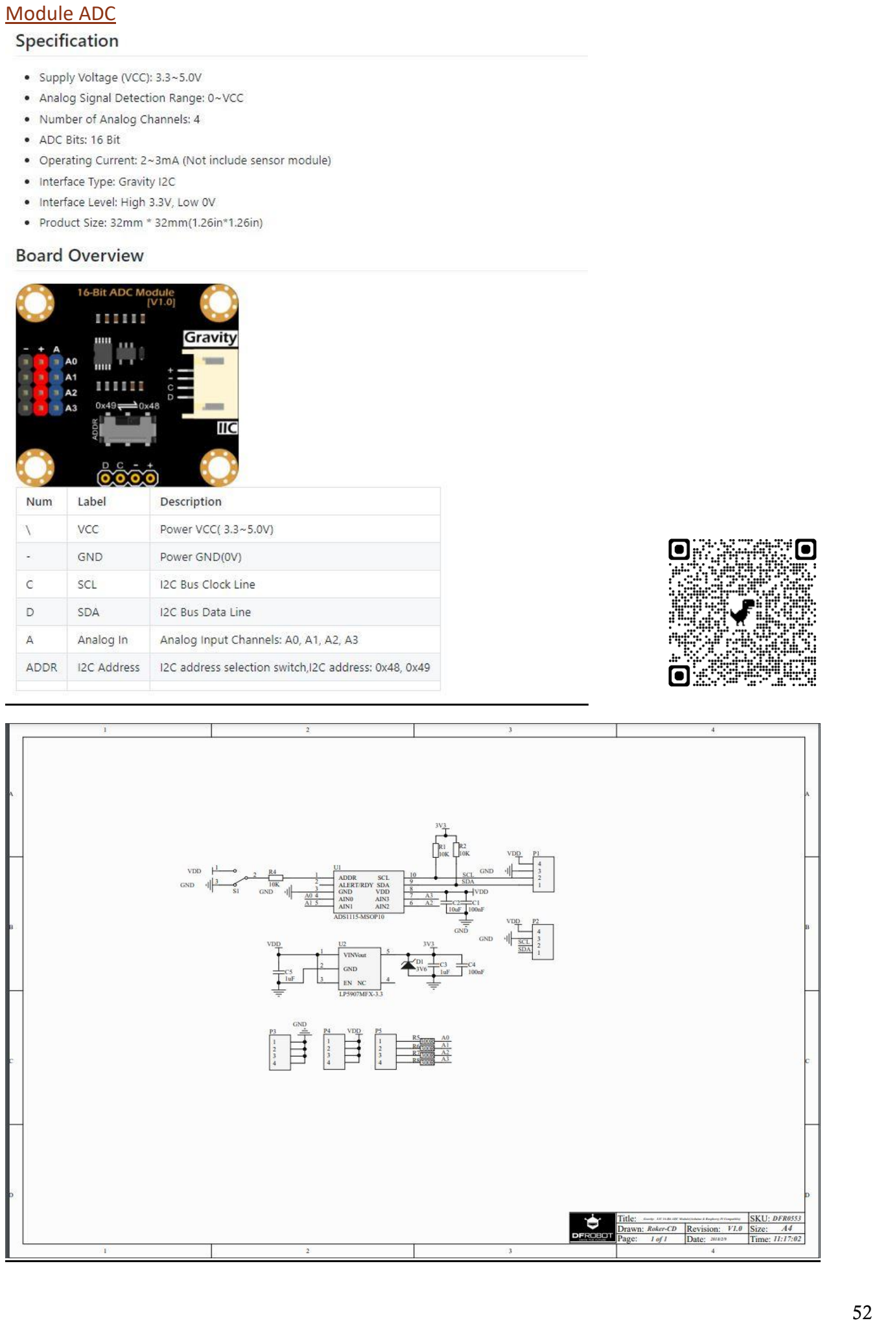
[picture p50: page 53]

Module ADC

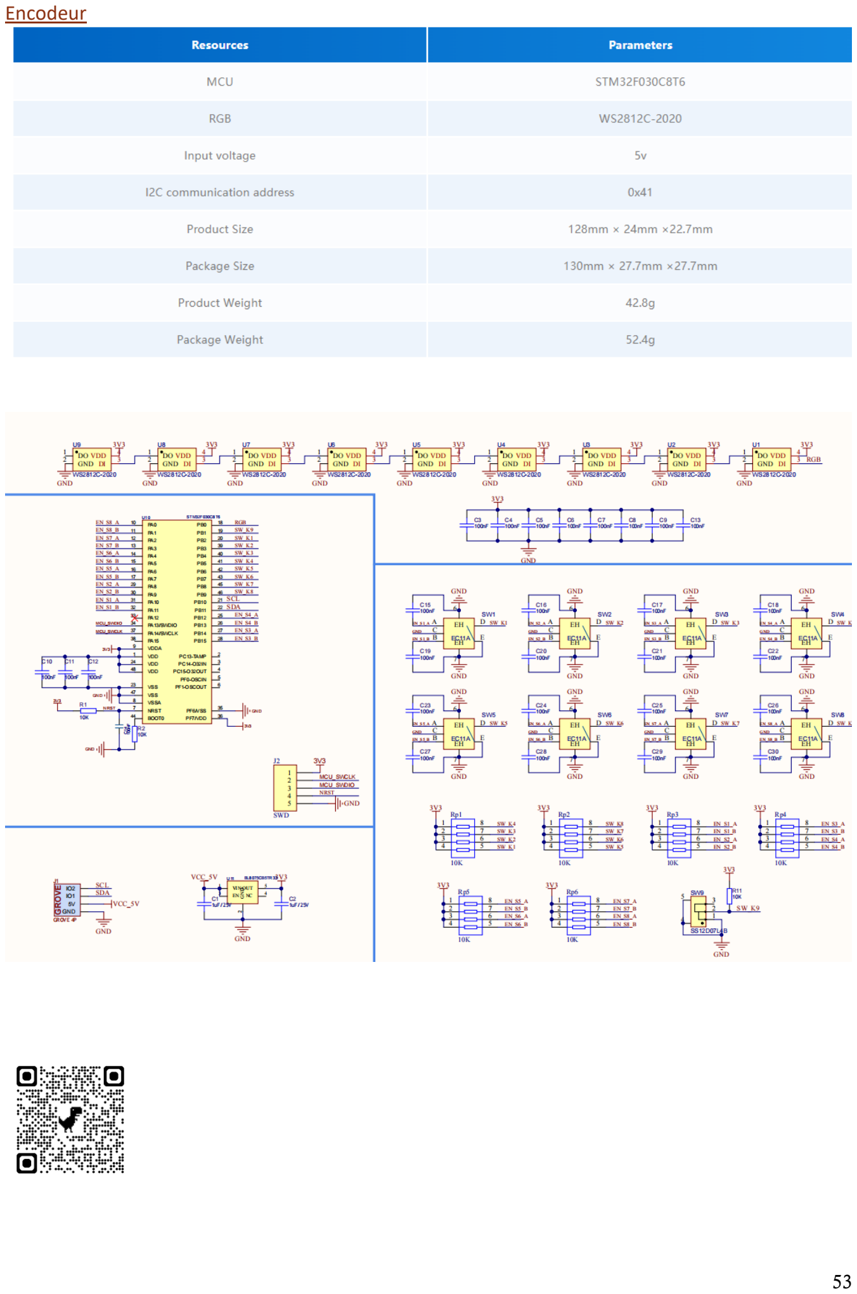
[picture p51: page 54]

Encodeur

## 13. Bibliographie et webographie

Consulté le 1/02/2024

Explication de l’encodeur incrémentale (https://www.youtube.com/watch?v=SCR5YJZVyKg) 18h34

Fonctionnement de l’encodeur (https://www.sick.com/fr/fr/sick-sensor-blog/codeur-incremental-fonctionnement-applications-et-produits-sick/w/blog-incremental-encoder-base/) 18h45

Datasheet de l’encodeur (https://docs.m5stack.com/en/unit/UNIT%208EnCoder)
18h53

Encodeur rotatif (https://passionelectronique.fr/encodeur-rotatif-incremental-mecanique/)
18h12

I²C (http://electro8051.free.fr/I2C/busi2c.htm)
19h

Adc (https://www.monolithicpower.com/en/analog-to-digital-converters/detailed-analysis-of-adc-architectures/delta-sigma-adcs)

Adc delta sigma (https://dewesoft.com/fr/blog/types-de-convertisseurs-adc)

Différence entre les Bluetooth (https://elainnovation.com/difference-entre-bluetooth-et-bluetooth-low-energy/) 20h32

Démodulation (https://www.geeksforgeeks.org/what-is-demodulation/)
21h

Fonctionnement de la Démodulation (https://polaridad.es/fr/Qu%27est-ce-que-gfsk-et-comment-fonctionne-la-modulation-de-fr%C3%A9quence-gaussienne%C2%A0%3F/) 21h09

Consulté le 10/10/2024

Servomoteur (https://paulo.pagesperso-orange.fr/public/robotv1/Servo_9g_Doc_JPW.pdf)

18h30

Main robotisée (https://it.aliexpress.com/item/1005003241919629.html?mp=1)

18h 36

ADC datasheet (https://www.ti.com/lit/ds/symlink/ads1115.pdf?ts=1716860903852)

Capteur de flexion (https://www.amazon.com.be/Capteur-ZD10-100-Pression-R%C3%A9sistance-Sensible/dp/B08B88W3H5?hvadid=633259889703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)

19h

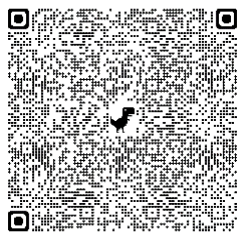
[picture p52: figure]

Projet (https://www.gotronic.fr/blog/articles/controle-dune-main-robotique/)

17h30

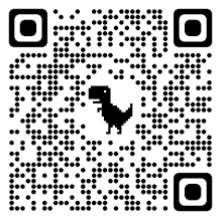
[picture p53: figure]

Esp32 (https://makeabilitylab.github.io/physcomp/esp32/esp32.html)

18h

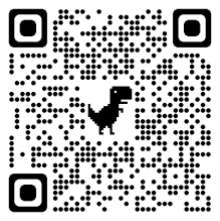
[picture p54: figure]

M5paper (https://docs.m5stack.com/en/core/m5paper)

18h20

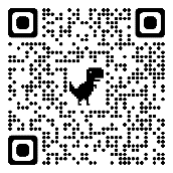
[picture p55: figure]
