Daoud1190/Reception_moteur_main/(commit log)

2024-05-24 ajout d'un tableau de presentation README.md
2024-05-25 ajout d'une table des matières
2024-05-25 Ajout de la transmission
2024-06-04 vrai vidéo de démo
